xtnctx/BFRBSys/Docs/Images/300px-Nailbitebad.jpg

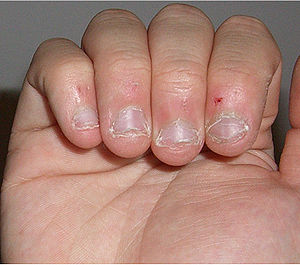
Docs/Images/300px-Nailbitebad.jpg
