xtnctx/BFRBSys/website/media/ProfilePics/anya-forger--spyxanya.png

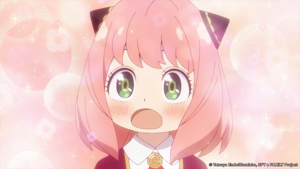
website/media/ProfilePics/anya-forger--spyxanya.png
