xtnctx/BFRBSys/Design/README.md

# Casing 3D Design
* Main
* External (Temperature & distance sensor)
