xtnctx/BFRBSys/Docs/capsule_diagram.png

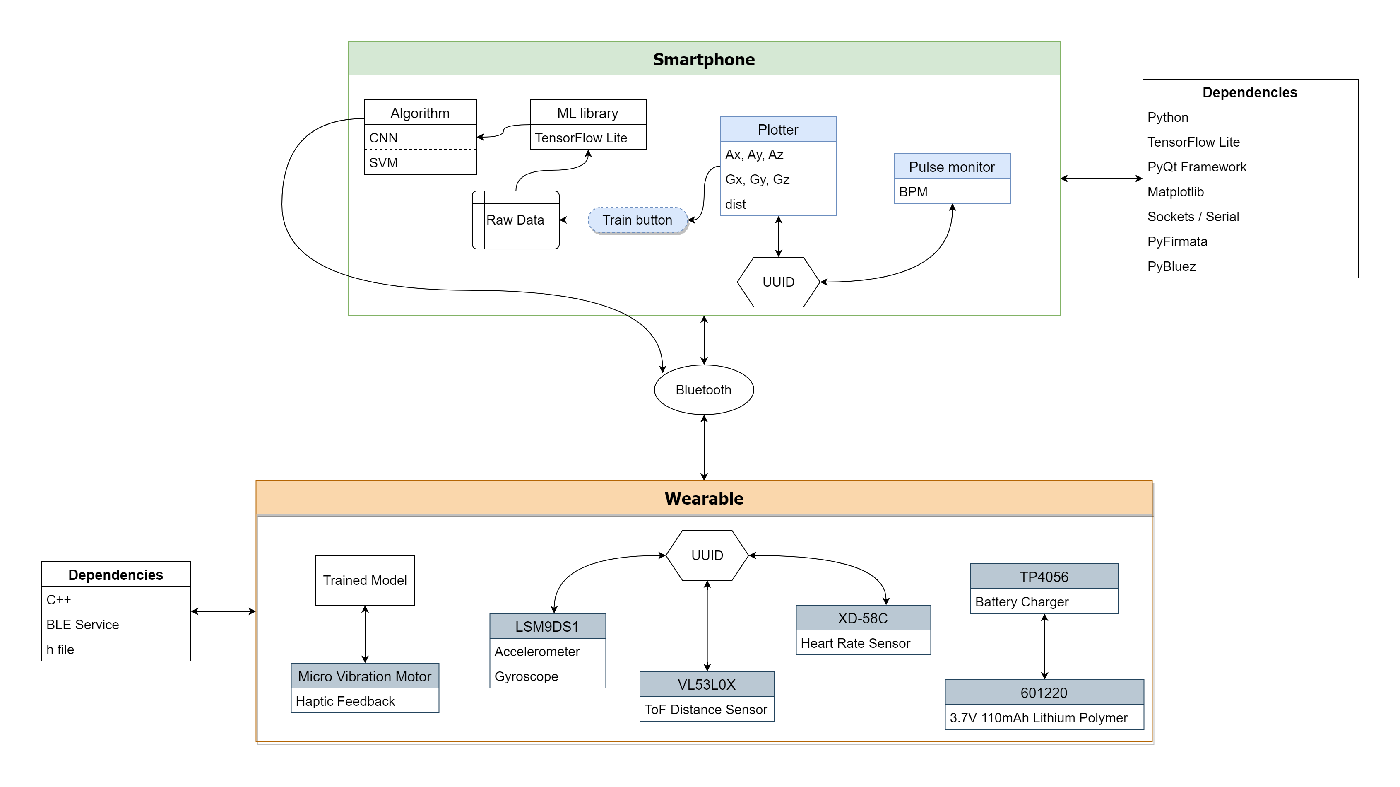
Docs/capsule_diagram.png
