xtnctx/BFRBSys/Docs/Images/10-tips-to-stop-biting-your-nails-onychophagia.jpg

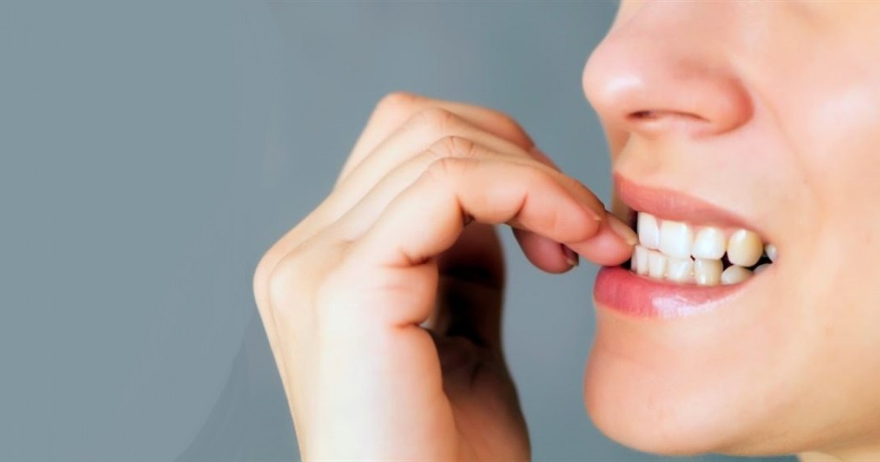
Docs/Images/10-tips-to-stop-biting-your-nails-onychophagia.jpg
