xtnctx/BFRBSys/Docs/Images/57dd166d12f08fd1103d0b2965c6aeb9.jpg

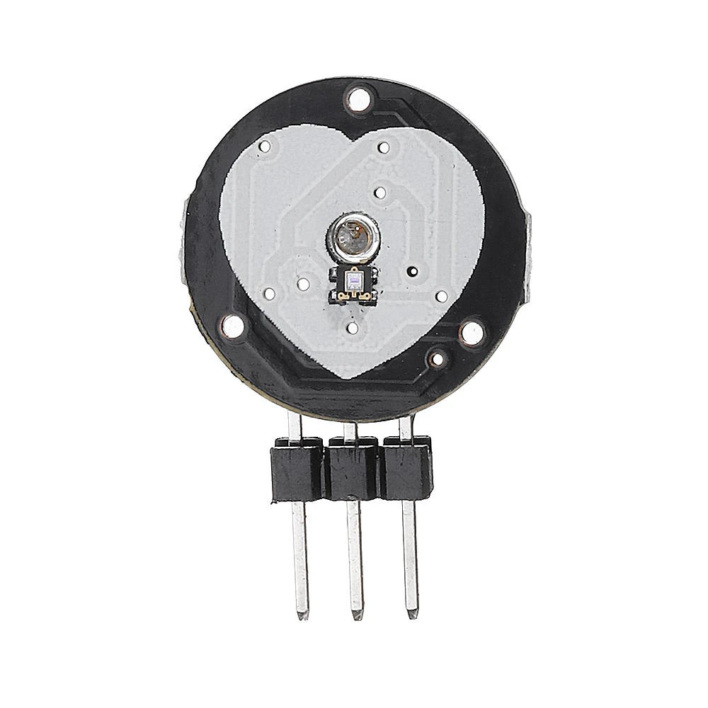
Docs/Images/57dd166d12f08fd1103d0b2965c6aeb9.jpg
