xtnctx/BFRBSys/Docs/Images/143px-Onychophagia.jpg

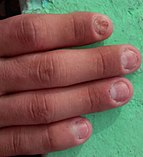
Docs/Images/143px-Onychophagia.jpg
