xtnctx/BFRBSys/Docs/Images/220px-Excoriation_disorder_affecting_face.jpg

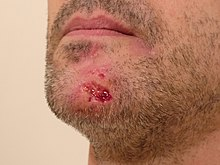
Docs/Images/220px-Excoriation_disorder_affecting_face.jpg
