xtnctx/BFRBSys/Docs/Images/300px-Trichotillomania_1.jpg

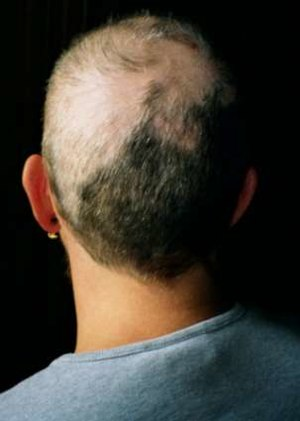
Docs/Images/300px-Trichotillomania_1.jpg
