xtnctx/BFRBSys/Docs/Images/978-3-540-29668-3_20_Part_Fig6_HTML.jpg

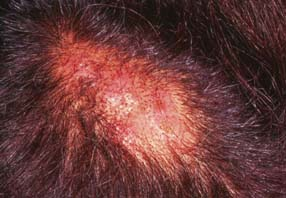
Docs/Images/978-3-540-29668-3_20_Part_Fig6_HTML.jpg
