xtnctx/BFRBSys/Docs/Images/1200px-Derma_me.jpg

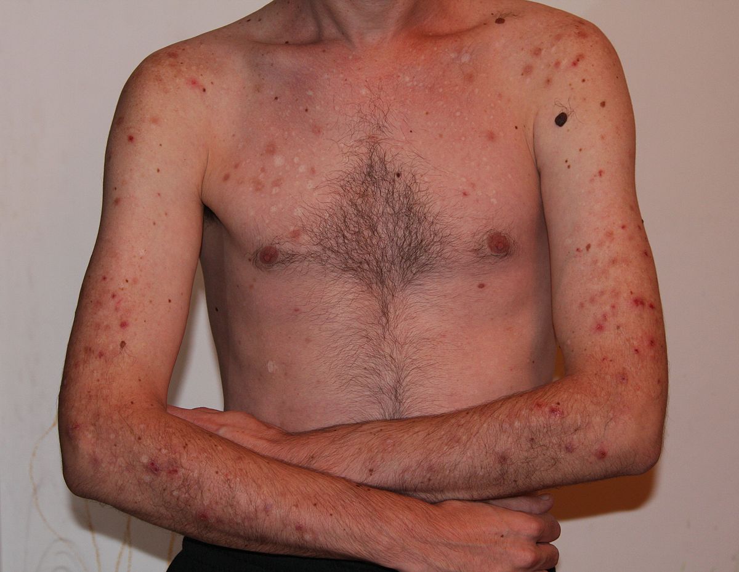
Docs/Images/1200px-Derma_me.jpg
