xtnctx/BFRBSys/Docs/Images/021239011ceeaafb5a526eff2fa90577.jpg

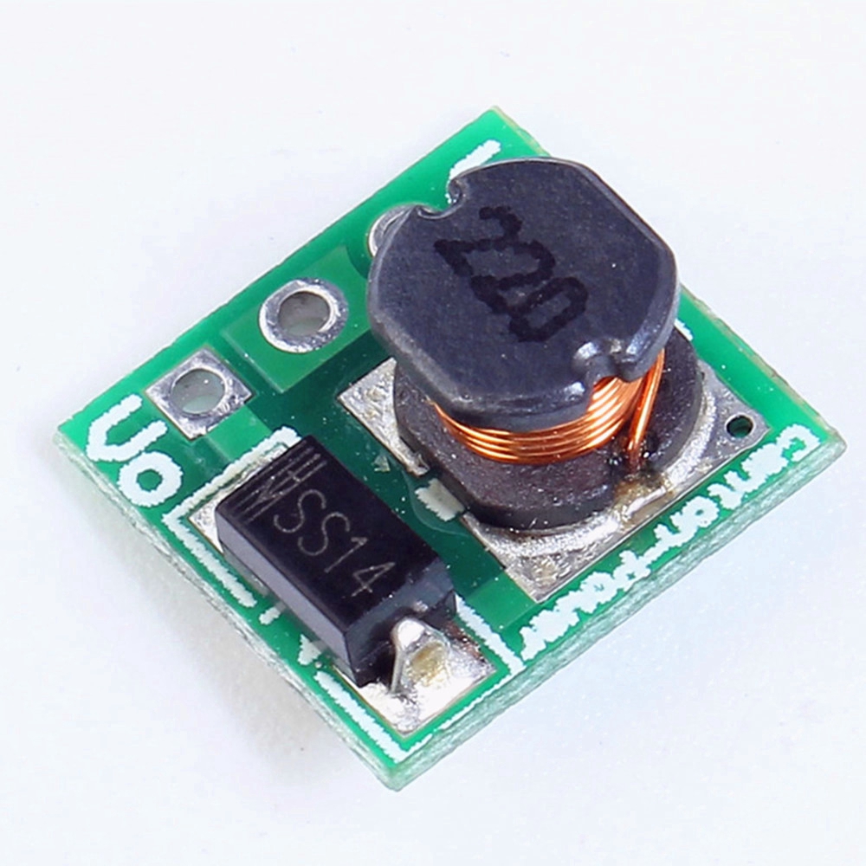
Docs/Images/021239011ceeaafb5a526eff2fa90577.jpg
