xtnctx/BFRBSys/Docs/Images/ABX00031_03.front_1000x750.jpg

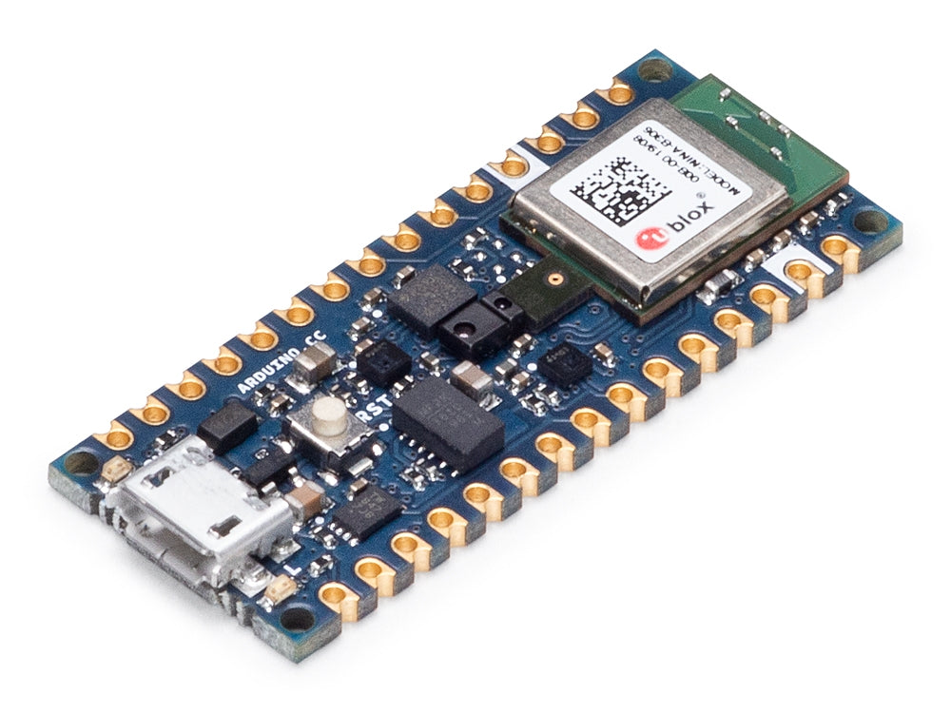
Docs/Images/ABX00031_03.front_1000x750.jpg
