xtnctx/BFRBSys/Docs/Images/capsule_diagram.png

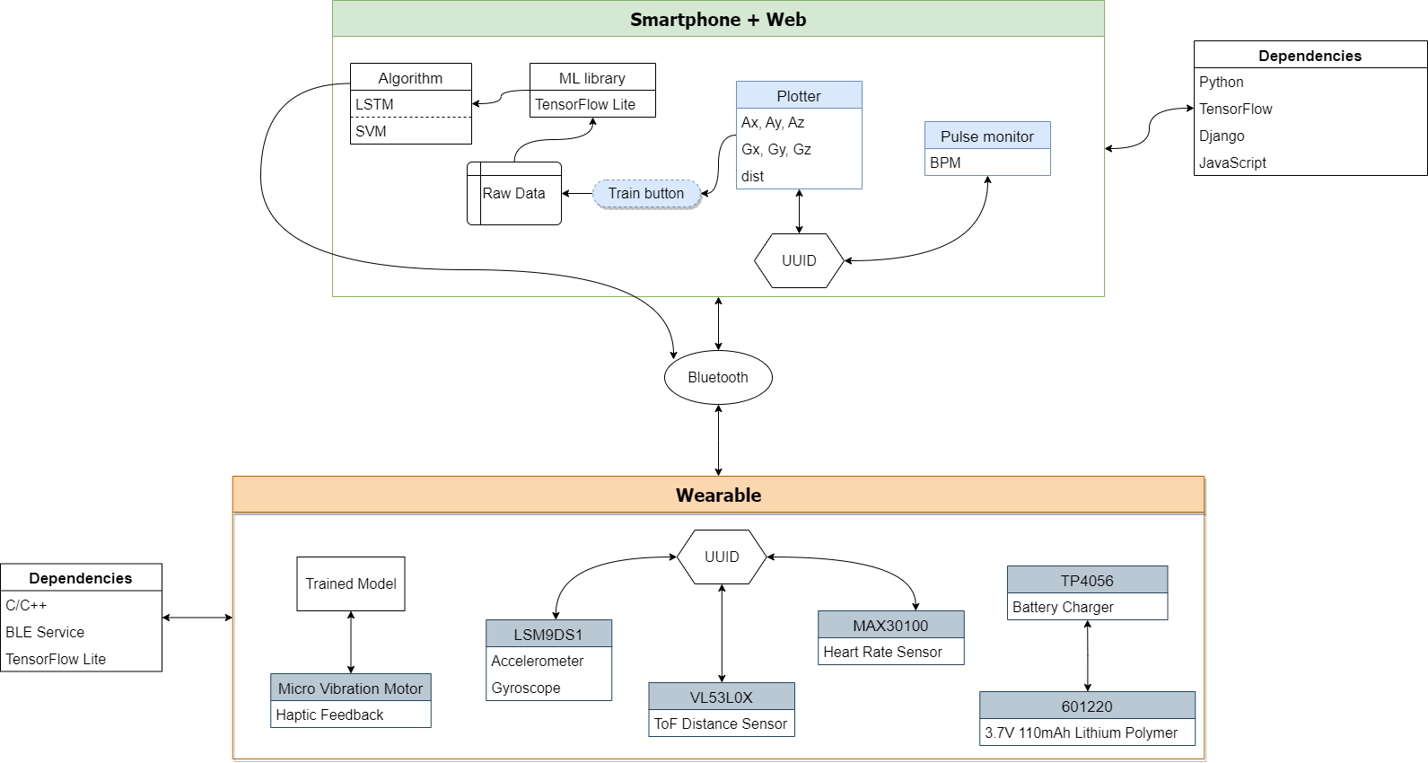
Docs/Images/capsule_diagram.png
