xtnctx/BFRBSys/Docs/Images/case3Dprint.png

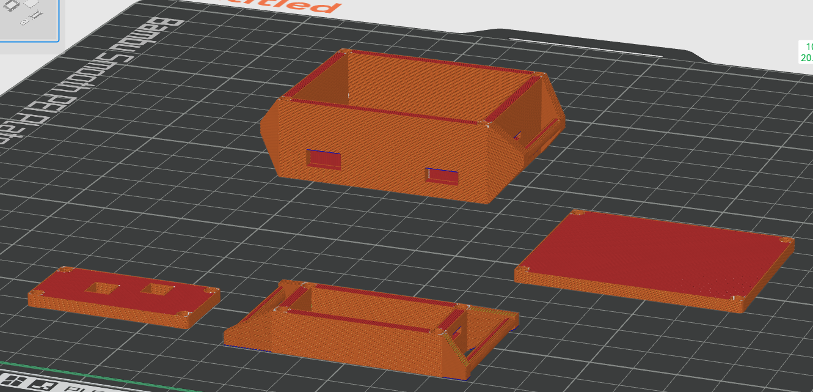
Docs/Images/case3Dprint.png
