xtnctx/BFRBSys/Docs/Images/download (1).jpg

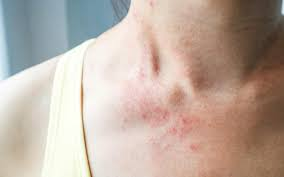
Docs/Images/download (1).jpg
