xtnctx/BFRBSys/Docs/Images/download.jpg

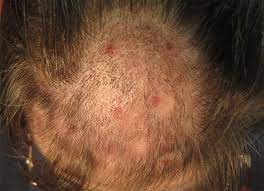
Docs/Images/download.jpg
