xtnctx/BFRBSys/Docs/Images/externalboard-development.jpg

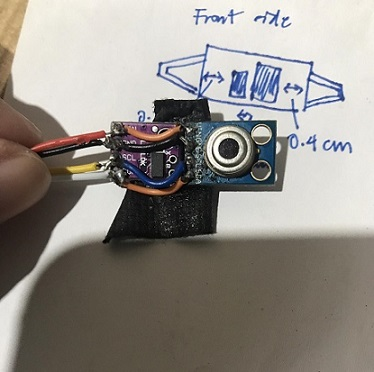
Docs/Images/externalboard-development.jpg
