xtnctx/BFRBSys/Docs/Images/FAyVRbtXoAsD0iX.png

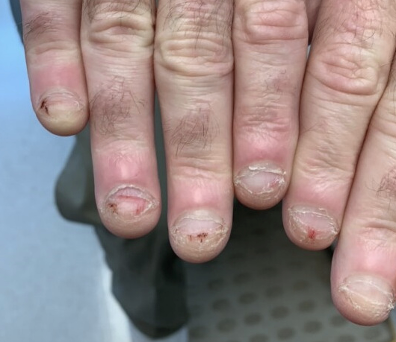
Docs/Images/FAyVRbtXoAsD0iX.png
