xtnctx/BFRBSys/Docs/Images/mainboard-development.jpg

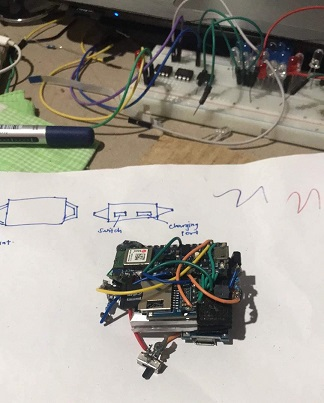
Docs/Images/mainboard-development.jpg
