xtnctx/BFRBSys/Docs/Images/nano33BS_02_acceleration.png

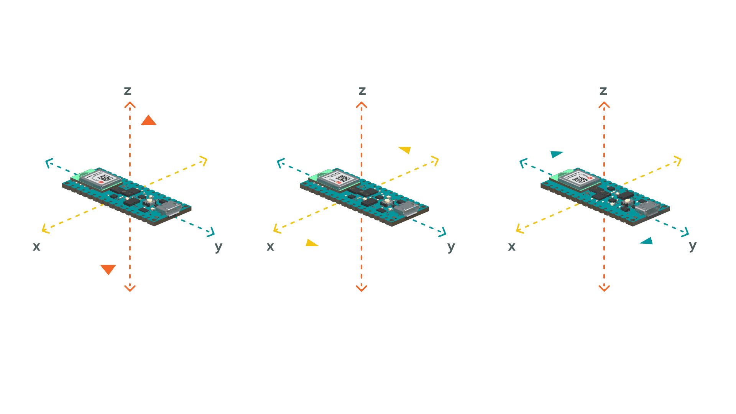
Docs/Images/nano33BS_02_acceleration.png
