xtnctx/BFRBSys/Docs/Images/nano33BS_03_IMU.png

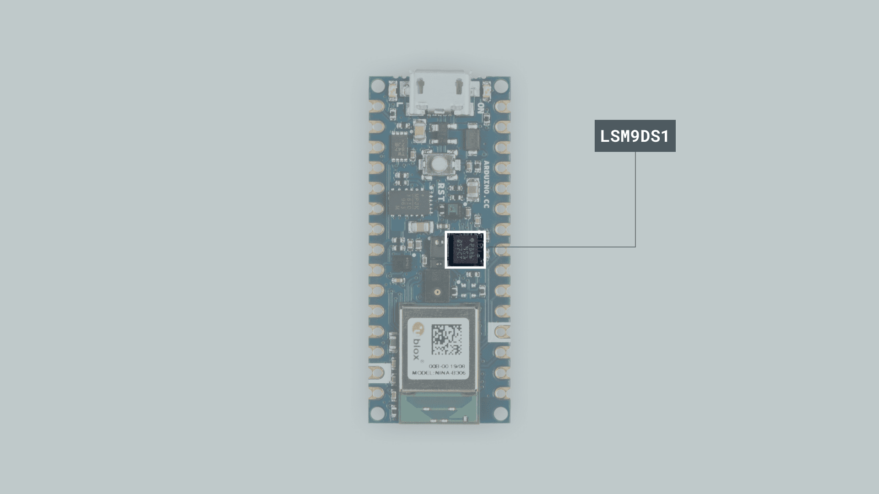
Docs/Images/nano33BS_03_IMU.png
