xtnctx/BFRBSys/Docs/Images/pickingSkin-900475670-770x553-650x428.jpg

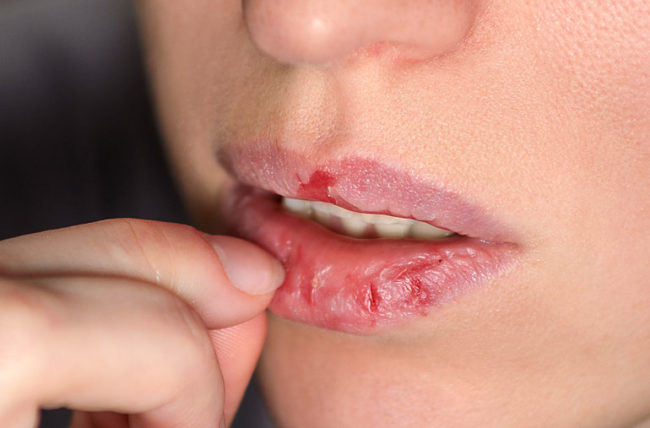
Docs/Images/pickingSkin-900475670-770x553-650x428.jpg
