xtnctx/BFRBSys/Docs/Images/render_sketch.png

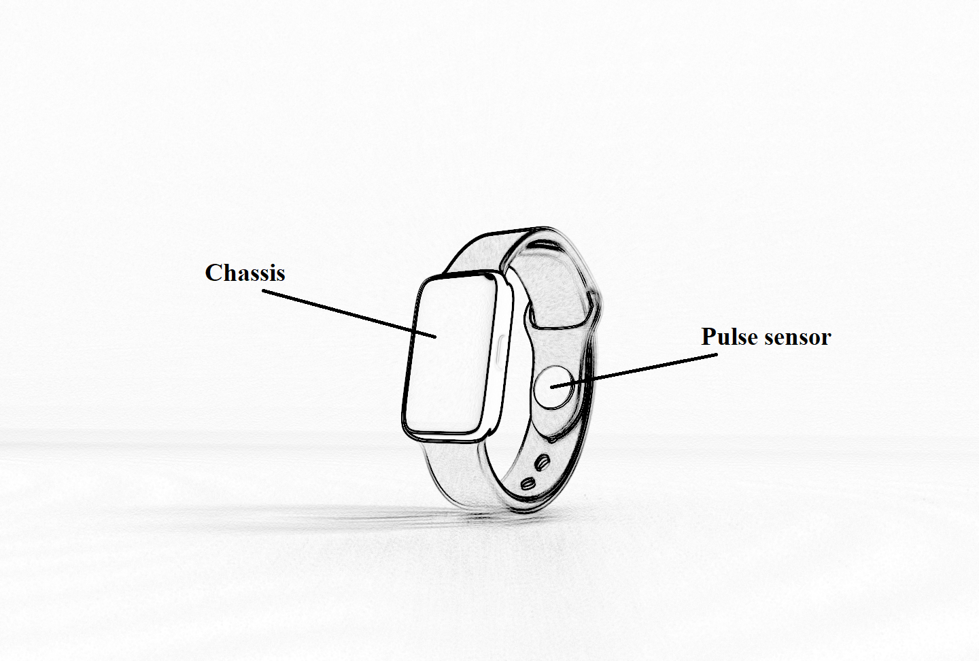
Docs/Images/render_sketch.png
