xtnctx/BFRBSys/Docs/Images/render_sketch_back.png

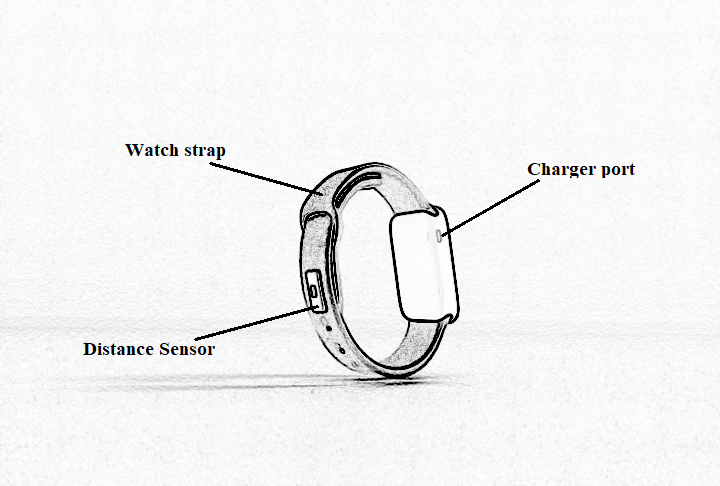
Docs/Images/render_sketch_back.png
