xtnctx/BFRBSys/Docs/Images/render_sketch_open.png

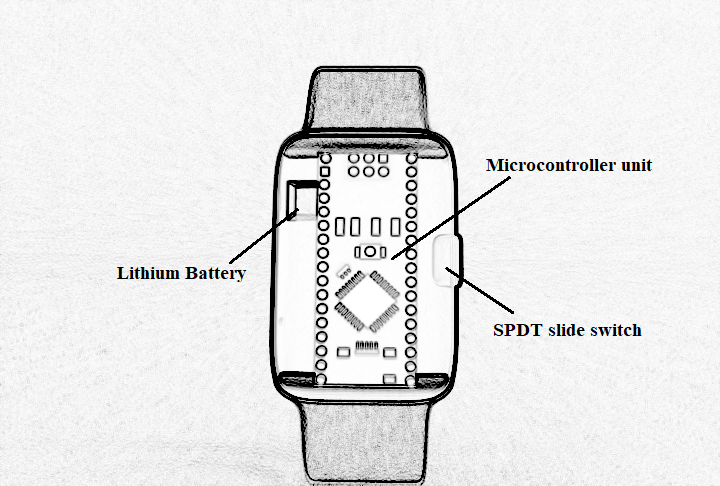
Docs/Images/render_sketch_open.png
