xtnctx/BFRBSys/Docs/Images/renders/render1.png

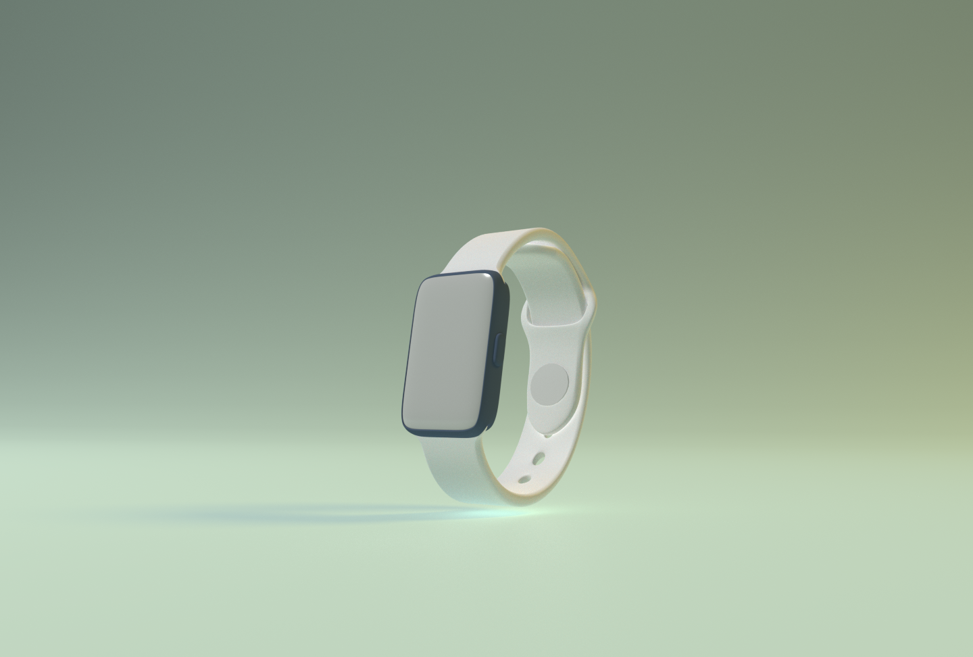
Docs/Images/renders/render1.png
