xtnctx/BFRBSys/Docs/Images/renders/render_sketch.png

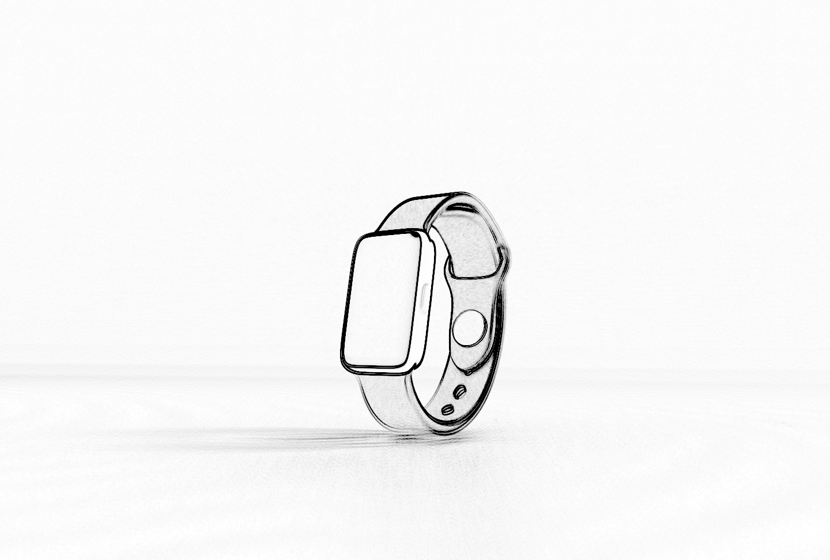
Docs/Images/renders/render_sketch.png
