xtnctx/BFRBSys/Docs/Images/renders/render_sketch_back.png

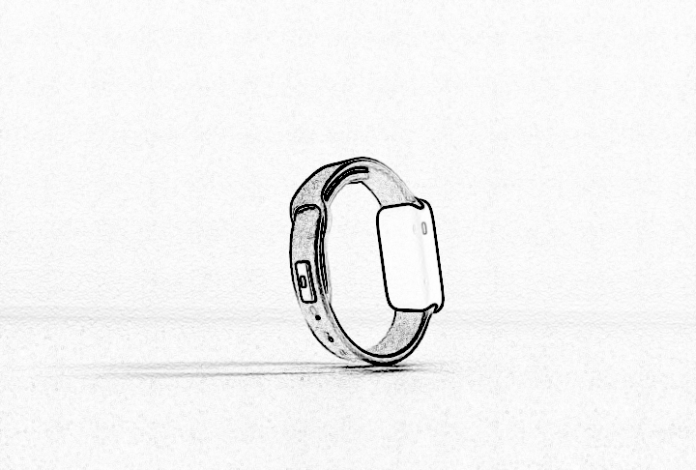
Docs/Images/renders/render_sketch_back.png
