xtnctx/BFRBSys/Docs/Images/renders/render_sketch_open.png

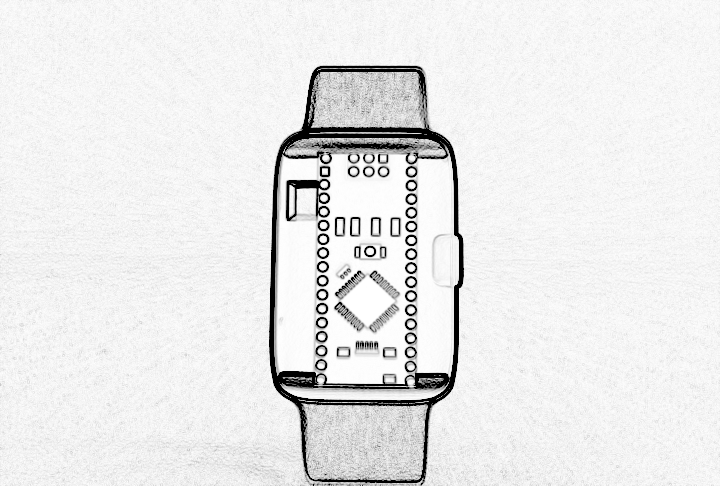
Docs/Images/renders/render_sketch_open.png
