xtnctx/BFRBSys/Docs/Images/Screenshots/monitoring_page.png

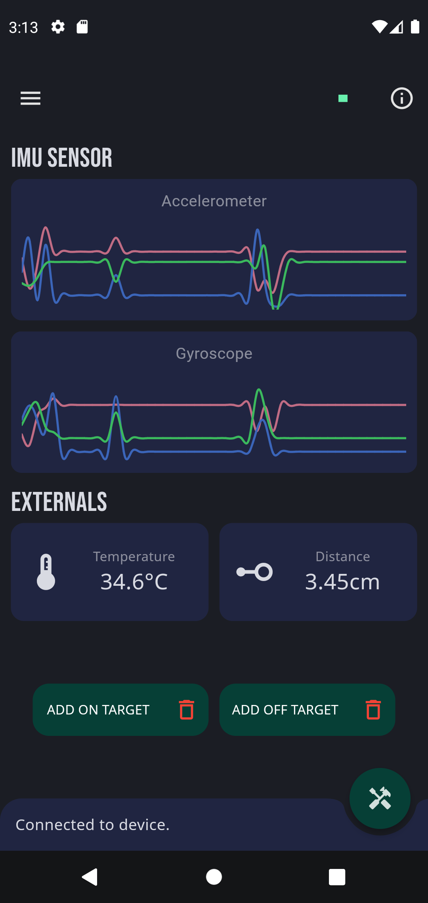
Docs/Images/Screenshots/monitoring_page.png
