xtnctx/BFRBSys/Docs/Images/signal.png

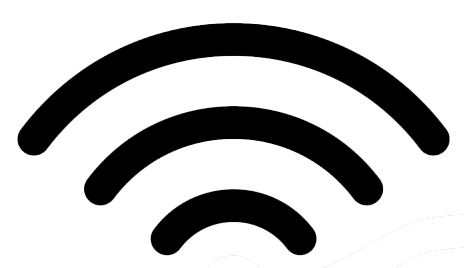
Docs/Images/signal.png
