xtnctx/BFRBSys/Docs/Images/Small-Rechargeable-601220-3-7V-100mAh-Lithium-Polymer-Battery-for-Speaker.jpg

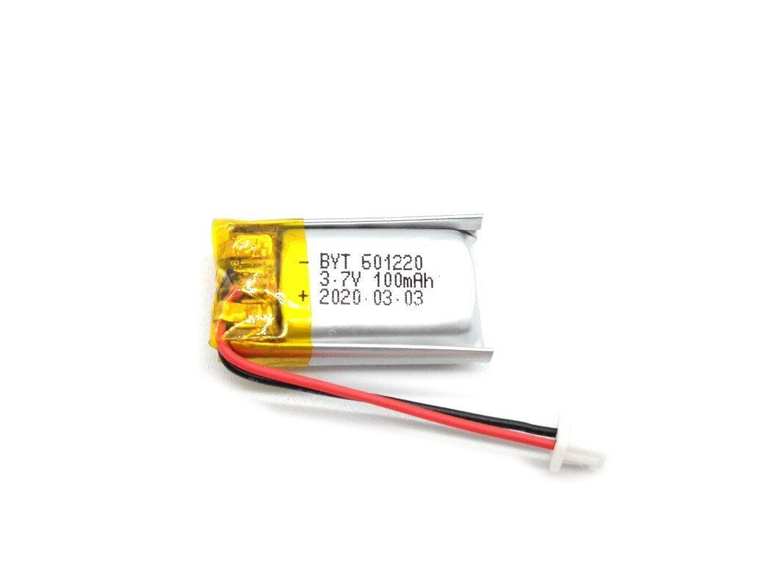
Docs/Images/Small-Rechargeable-601220-3-7V-100mAh-Lithium-Polymer-Battery-for-Speaker.jpg
