xtnctx/BFRBSys/Docs/Images/tensorflow_flowchart.png

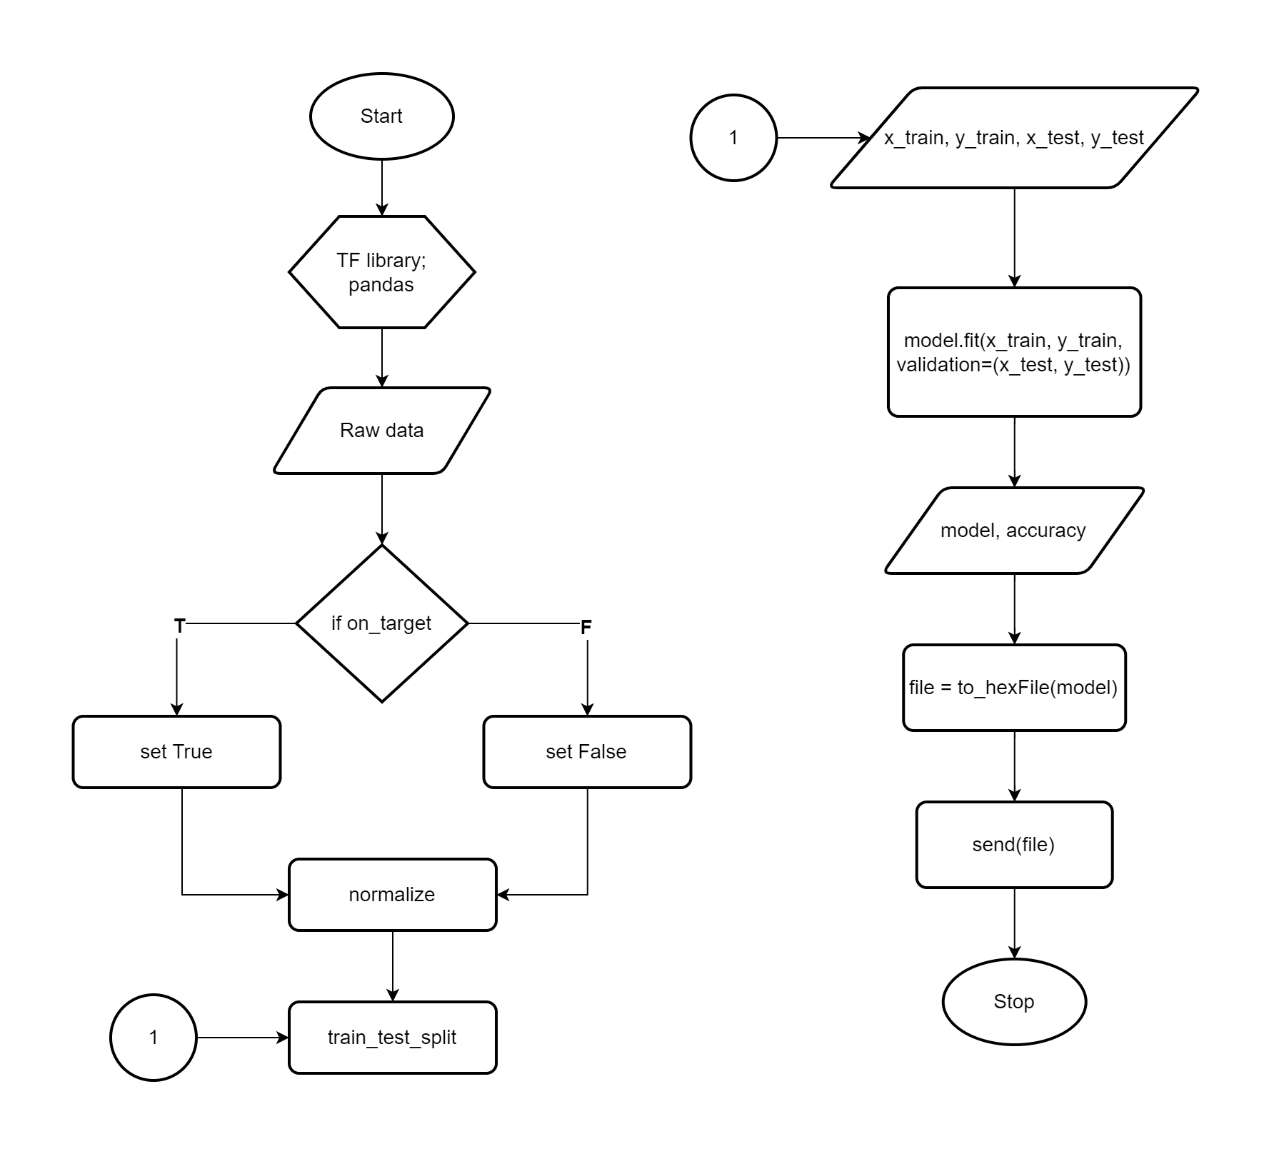
Docs/Images/tensorflow_flowchart.png
