xtnctx/BFRBSys/Docs/Images/ToF sensor.jpg

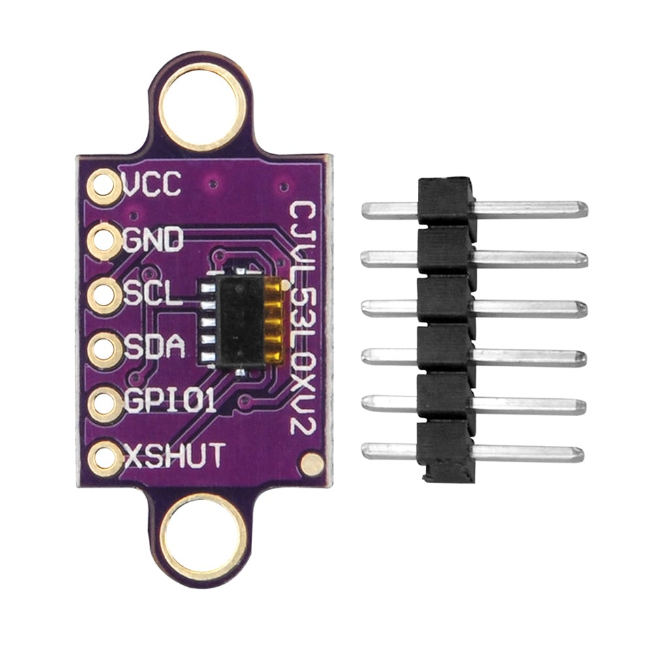
Docs/Images/ToF sensor.jpg
