xtnctx/BFRBSys/Docs/Images/tp4056.jpg

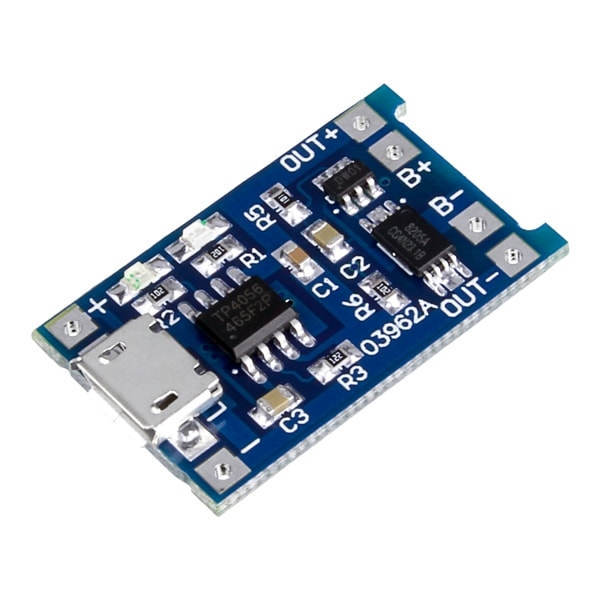
Docs/Images/tp4056.jpg
