xtnctx/BFRBSys/Docs/Images/Trichotillomania_2.jpg

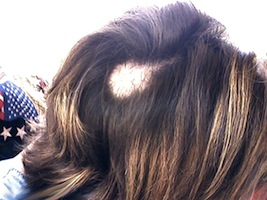
Docs/Images/Trichotillomania_2.jpg
