xtnctx/BFRBSys/FlutterApp/images/drawerbg.jpg

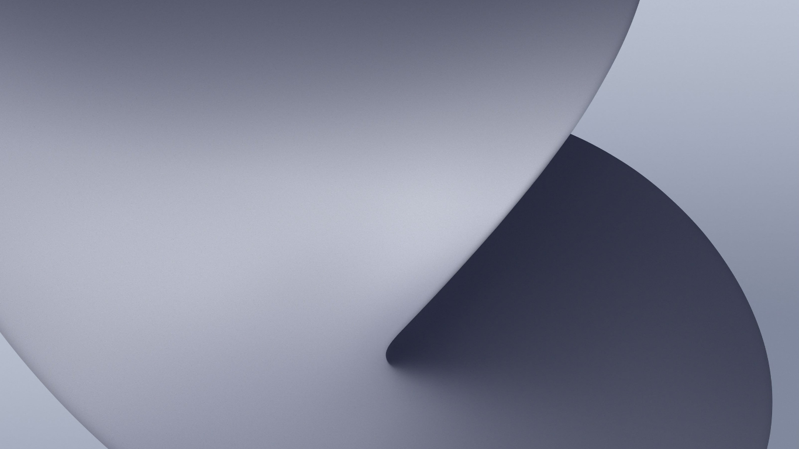
FlutterApp/images/drawerbg.jpg
