xtnctx/BFRBSys/FlutterApp/images/pixabay.jpg

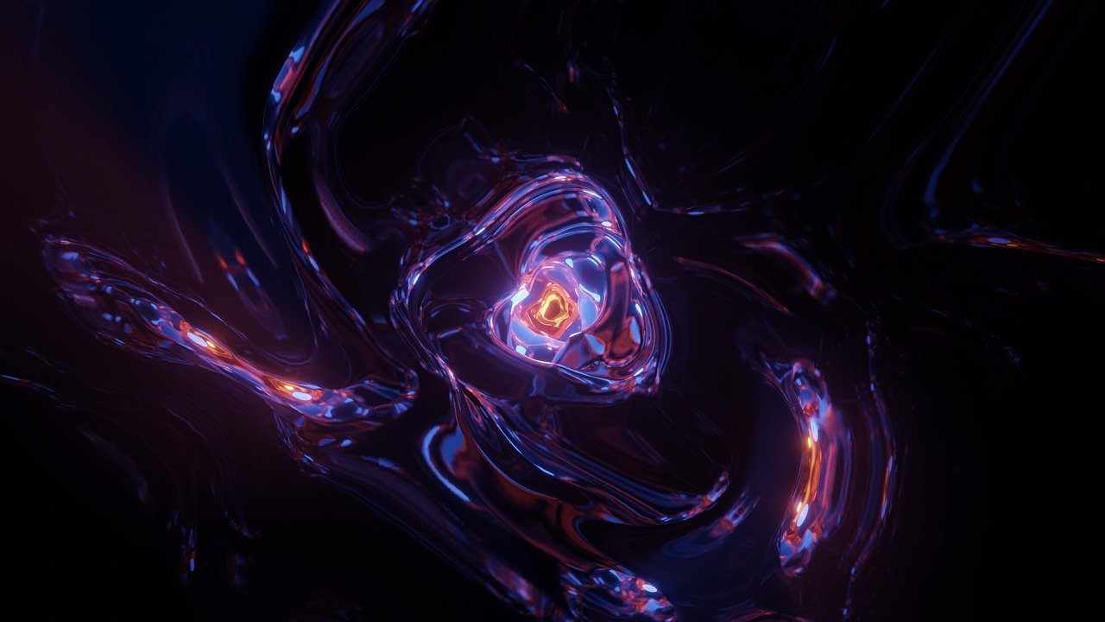
FlutterApp/images/pixabay.jpg
