xtnctx/BFRBSys/FlutterApp/images/raindrops.gif

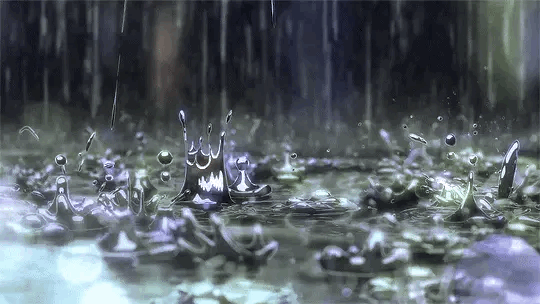
FlutterApp/images/raindrops.gif
