xtnctx/BFRBSys/website/media/default.jpg

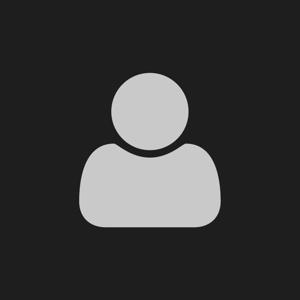
website/media/default.jpg
