xtnctx/BFRBSys/website/media/ProfilePics/christopher_bahillo_YT--ryan.jpg

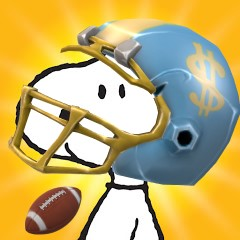
website/media/ProfilePics/christopher_bahillo_YT--ryan.jpg
