xtnctx/BFRBSys/website/media/ProfilePics/yor--yorforger321.jpg

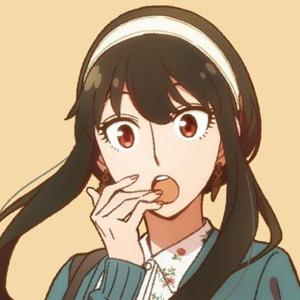
website/media/ProfilePics/yor--yorforger321.jpg
