xtnctx/BFRBSys/Docs/Images/Screenshots/result_page.png

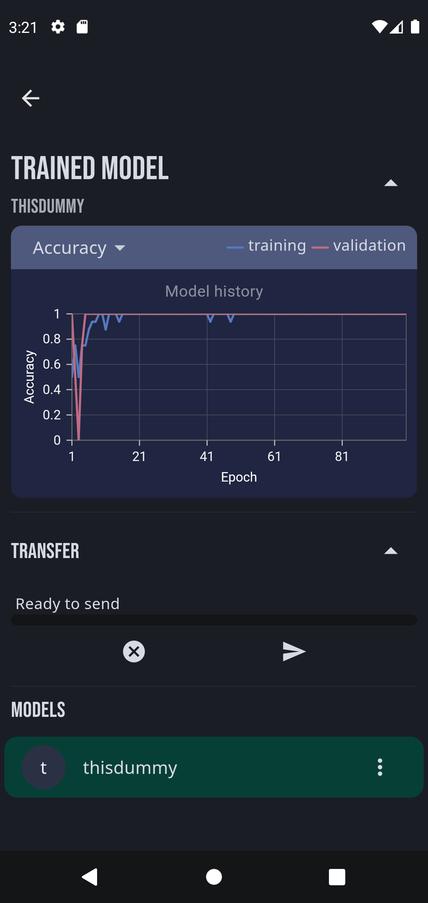
Docs/Images/Screenshots/result_page.png
