xtnctx/BFRBSys/(threads)

Thread 3 (2022-09-08):

model training in BLE Sense is not present

xtnctx, 2022-09-08:
# Fix
- after transferring the model, the device won't get trained

Closed 2023-10-20.
