xtnctx/BFRBSys/bfrbsysAPI/apis/views.py

''' Copyright 2024 Ryan Christopher Bahillo. All Rights Reserved.
Licensed under the Apache License, Version 2.0 (the "License");
you may not use this file except in compliance with the License.
You may obtain a copy of the License at
    http://www.apache.org/licenses/LICENSE-2.0
Unless required by applicable law or agreed to in writing, software
distributed under the License is distributed on an "AS IS" BASIS,
WITHOUT WARRANTIES OR CONDITIONS OF ANY KIND, either express or implied.
See the License for the specific language governing permissions and
limitations under the License.
========================================================================='''

import base64
from django.shortcuts import render
from django.http import JsonResponse
from rest_framework.response import Response
from rest_framework.decorators import api_view
from rest_framework.views import APIView
from .models import Item, TrainedModel

from .serializers import (ItemSerializer, TrainedModelSerializer, UserSerializer,
    RegisterSerializer, LoginSerializer)

from rest_framework.permissions import IsAuthenticated
from rest_framework import status, generics
from rest_framework.authentication import TokenAuthentication, SessionAuthentication, BasicAuthentication
from rest_framework.authtoken.models import Token
from .utils import *
from django.conf import settings
import os
import json

from knox.models import AuthToken
from knox.views import LoginView as KnoxLoginView

from rest_framework.permissions import AllowAny
from rest_framework.authtoken.serializers import AuthTokenSerializer
from django.contrib.auth import login
from django.forms.models import model_to_dict

from django.core.files.base import ContentFile
from .train import BFRBNeuralNetwork
import zipfile
from io import BytesIO
from django.http import HttpResponse

#
import numpy as np
import csv
import tensorflow as tf


PARAMS = ['ax', 'ay', 'az', 'gx', 'gy', 'gz', 'class']
SAMPLES_PER_HOTSPOT = 1

def home(request):
    return render(request, 'apis/home.html', {})

class NeuralNetworkBuilder(APIView):
    """
    TEST TEST TEST TEST TEST TEST TEST TEST 
    """
    
    permission_classes = (IsAuthenticated,)

    def get(self, request, format=None):
        items = Item.objects.all()
        serializer = ItemSerializer(items, many=True)
        # token, _ = Token.objects.get(user=request.user)
        

        return Response(serializer.data)
    
    def post(self, request, format=None):
        data = request.data.get('data')
        named_model = request.data.get('model_name')
        file = request.data.get("file")
        fileName = request.data.get("fileName")
        
        if named_model == '':
            named_model = 'NO_NAME_MODEL'

        # nn = BFRBNeuralNetwork(data=file).build()
        # train, val = nn.preprocessData(train_rate=0.8, val_rate=0.2)
        # history, model = nn.train(trainData=train, valData=val)
        # tflite_model = nn.to_tflite(model)

        ##################
        
        df = pd.read_csv(file)
        off_target = pd.DataFrame(df[df['class']==0].values.tolist(), columns=PARAMS)
        on_target = pd.DataFrame(df[df['class']==1].values.tolist(), columns=PARAMS)

        HOTSPOT = [off_target, on_target] # known location / class
        NUM_HOTSPOT = len(HOTSPOT)
        ONE_HOT_ENCODED_HOTSPOT = np.eye(NUM_HOTSPOT)
        N_EPOCH = 600

        inputs = []
        outputs = []

        for hotspot_index in range(NUM_HOTSPOT):

            target = HOTSPOT[hotspot_index]

            num_recordings = int(target.shape[0] / SAMPLES_PER_HOTSPOT)

            output = ONE_HOT_ENCODED_HOTSPOT[hotspot_index]

            print(f"\tThere are {num_recordings} recordings.")

            for i in range(num_recordings):
                tensor = []
                for j in range(SAMPLES_PER_HOTSPOT):
                    index = i * SAMPLES_PER_HOTSPOT + j
                    # normalize the input data, between 0 to 1:
                    # - acceleration is between: -4 to +4
                    # - gyroscope is between: -2000 to +2000
                    tensor += [
                        (float(target['ax'][index]) + 4) / 8,
                        (float(target['ay'][index]) + 4) / 8,
                        (float(target['az'][index]) + 4) / 8,
                        (float(target['gx'][index]) + 2000) / 4000,
                        (float(target['gy'][index]) + 2000) / 4000,
                        (float(target['gz'][index]) + 2000) / 4000
                    ]
                inputs.append(tensor)
                outputs.append(output)


        # convert the list to numpy array
        inputs = np.array(inputs)
        outputs = np.array(outputs)

        
        # Randomize the order of the inputs, so they can be evenly distributed for training, testing, and validation
        # https://stackoverflow.com/a/37710486/2020087
        num_inputs = len(inputs)
        randomize = np.arange(num_inputs)
        np.random.shuffle(randomize)

        # Swap the consecutive indexes (0, 1, 2, etc) with the randomized indexes
        inputs = inputs[randomize]
        outputs = outputs[randomize]

        # Split the recordings (group of samples) into three sets: training, testing and validation
        TRAIN_SPLIT = int(0.6 * num_inputs)
        TEST_SPLIT = int(0.2 * num_inputs + TRAIN_SPLIT)

        inputs_train, inputs_test, inputs_validate = np.split(inputs, [TRAIN_SPLIT, TEST_SPLIT])
        outputs_train, outputs_test, outputs_validate = np.split(outputs, [TRAIN_SPLIT, TEST_SPLIT])
        
        # build the model and train it
        model = tf.keras.Sequential()
        model.add(tf.keras.layers.Dense(50, activation='relu')) # relu is used for performance
        model.add(tf.keras.layers.Dense(15, activation='relu'))
        model.add(tf.keras.layers.Dense(NUM_HOTSPOT, activation='softmax')) # softmax is used, because we only expect one hotspot to occur per input
        model.compile(optimizer='rmsprop', loss='mse', metrics=['mae'])
        # history = model.fit(inputs_train, outputs_train, epochs=N_EPOCH, batch_size=1,
        #                     validation_data=(inputs_validate, outputs_validate),
        #                     callbacks=[EpochPrintingCallback(msg, N_EPOCH)])

        history = model.fit(inputs_train, outputs_train, epochs=N_EPOCH, batch_size=1,
                            validation_data=(inputs_validate, outputs_validate))

        
        # Convert the model to the TensorFlow Lite format without quantization
        converter = tf.lite.TFLiteConverter.from_keras_model(model)
        converter.optimizations = [tf.lite.Optimize.OPTIMIZE_FOR_SIZE]
        tflite_model = converter.convert()

        ############

        owner_file = str(named_model).replace(" ", "_") + f'--{request.user.username}'
        data = {
            'owner': request.user.id,
            'model_name': named_model,
            'file': ContentFile(bytes(model_to_databytes(tflite_model), 'utf-8'), 
                                name=owner_file + '_model.h'
                                ),
            'callback_file': ContentFile(bytes(callback_string(history), 'utf-8'), 
                                name=owner_file + '_callback.csv'),
        }

        serializer = TrainedModelSerializer(data=data)
        if serializer.is_valid():
            serializer.save()
            return Response(serializer.data, status=status.HTTP_201_CREATED)
        return Response(serializer.errors, status=status.HTTP_400_BAD_REQUEST)



    # def post(self, request, format=None):
    #     data = request.data.get('data')
    #     named_model = request.data.get('model_name')
    #     file = request.data.get("file") # Must be csv encoded
    #     fileName = request.data.get("fileName") # Must be csv file format

    #     dataset = ContentFile(base64.b64decode(file), fileName)
    #     df = pd.read_csv(dataset)
    #     print(df)

    #     if named_model == '':
    #         named_model = 'NO_NAME'
    #     # Save as temporary
    #     USER_TEMP_FILE = os.path.join(settings.MEDIA_ROOT, request.user.username + '_TEMPFILE.h')
    #     with open(USER_TEMP_FILE, 'w') as temp:
    #         # temp.write(hex_to_c_array(tflite_model))
    #         temp.write('hello')

    #     # Then save to database
    #     f = open(USER_TEMP_FILE, 'rb')
    #     data = {
    #         'owner': request.user.id,
    #         'model_name': named_model,
    #         'file': File(f, name=str(named_model).replace(" ", "_") + f'--{request.user.username}' + '.h')
    #     }
            
    #     model_string = rmv_file_spaces(USER_TEMP_FILE)
    #     print(model_string)

    #     serializer = TrainedModelSerializer(data=data)
    #     if serializer.is_valid():
    #         serializer.save()
    #         f.close()
    #         remove_file(USER_TEMP_FILE) # end of using temp model
    #         return Response(serializer.data, status=status.HTTP_201_CREATED)

    #     f.close()
    #     remove_file(USER_TEMP_FILE)
    #     return Response(serializer.errors, status=status.HTTP_400_BAD_REQUEST)


# class UserCreation(APIView):
#     """
#     API View to create or get a list of all the registered
#     users. GET request returns the registered users whereas
#     a POST request allows to create a new user.
#     """
#     permission_classes = [AllowAny]
    

#     # Delete later
#     def get(self, format=None):
#         users = User.objects.all()
#         serializer = UserSerializer(users, many=True)
#         return Response(serializer.data)

#     def post(self, request):
#         serializer = UserSerializer(data=request.data)
#         if serializer.is_valid(raise_exception=ValueError):
#             serializer.create(validated_data=request.data)
#             return Response(
#                 serializer.data,
#                 status=status.HTTP_201_CREATED
#             )
#         return Response(
#             {
#                 "error": True,
#                 "error_msg": serializer.error_messages,
#             },
#             status=status.HTTP_400_BAD_REQUEST
#         )


def get_all_user_models(request):
    # Files (local path) to put in the .zip
    # FIXME: Change this (get paths from DB etc)
    userTrainedModels = TrainedModel.objects.filter(owner=request.user)

    # Folder name in ZIP archive which contains the above files
    # E.g [thearchive.zip]/somefiles/file2.txt
    # FIXME: Set this to something better
    zip_subdir = request.user.username
    zip_filename = "%s.zip" % zip_subdir

    # Open StringIO to grab in-memory ZIP contents
    s = BytesIO()

    # The zip compressor
    zf = zipfile.ZipFile(s, "w")

    for model in userTrainedModels:
        # for fpath in filenames:
        # Calculate path for file in zip
        fpath = f'./media/{model.file.name}'
        fdir, fname = os.path.split(fpath)
        # TrainedModels
        zip_path = os.path.join(zip_subdir, f'{model.model_name}/{fname}')
        zf.write(fpath, zip_path)

        # Callbacks
        fpath = f'./media/{model.callback_file.name}'
        fdir, fname = os.path.split(fpath)
        zip_path = os.path.join(zip_subdir, f'{model.model_name}/{fname}')
        zf.write(fpath, zip_path)

        # Info
        data = model_to_dict(model)
        data['file'] = str(data['file'])
        data['callback_file'] = str(data['callback_file'])
        json_data = json.dumps(data, indent=4)
        zip_path = os.path.join(zip_subdir, f'{model.model_name}/{model.model_name}_info.json')
        zf.writestr(zip_path, json_data)
        s.seek(0)

    # Must close zip for all contents to be written
    zf.close()

    # Grab ZIP file from in-memory, make response with correct MIME-type
    resp = HttpResponse(s.getvalue(), content_type="application/x-zip-compressed")
    # ..and correct content-disposition
    resp['Content-Disposition'] = 'attachment; filename=%s' % zip_filename
    return resp


class RegisterAPI(generics.GenericAPIView):
    serializer_class = RegisterSerializer

    def post(self, request, *args, **kwargs):
        serializer = self.get_serializer(data=request.data)
        serializer.is_valid(raise_exception=True)
        user = serializer.save()
        _, token = AuthToken.objects.create(user)
        return Response({
            "user": UserSerializer(user, context=self.get_serializer_context()).data,
            "token": token
        })



class LoginAPI(generics.GenericAPIView):
    serializer_class = LoginSerializer
    permission_classes = ()

    def post(self, request, *args, **kwargs):
        serializer = self.get_serializer(data=request.data)
        serializer.is_valid(raise_exception=True)
        user = serializer.validated_data
        _, token = AuthToken.objects.create(user)
        return Response({
            "user": UserSerializer(user, context=self.get_serializer_context()).data,
            "token": token
        })


class UserAPI(generics.RetrieveAPIView):
  permission_classes = [IsAuthenticated]
  serializer_class = UserSerializer

  def get_object(self):
    return self.request.user
