xtnctx/BFRBSys/bfrbsysAPI/apis/serializers.py

''' Copyright 2024 Ryan Christopher Bahillo. All Rights Reserved.
Licensed under the Apache License, Version 2.0 (the "License");
you may not use this file except in compliance with the License.
You may obtain a copy of the License at
    http://www.apache.org/licenses/LICENSE-2.0
Unless required by applicable law or agreed to in writing, software
distributed under the License is distributed on an "AS IS" BASIS,
WITHOUT WARRANTIES OR CONDITIONS OF ANY KIND, either express or implied.
See the License for the specific language governing permissions and
limitations under the License.
========================================================================='''

from rest_framework import serializers
from .models import Item, TrainedModel
from django.contrib.auth.models import User
from rest_framework.validators import UniqueTogetherValidator
from django.contrib.auth import authenticate

class ItemSerializer(serializers.ModelSerializer):
    class Meta:
        model = Item
        fields = '__all__'

class TrainedModelSerializer(serializers.ModelSerializer):
    class Meta:
        model = TrainedModel
        fields = '__all__'



# class UserSerializer(serializers.ModelSerializer):
#     def create(self, validated_data):
#         user = User.objects.create_user(**validated_data)
#         return user

#     class Meta:
#         model = User
#         fields = (
#             'username',
#             'first_name',
#             'last_name',
#             'email',
#             'password',
#         )
#         validators = [
#             UniqueTogetherValidator(
#                 queryset=User.objects.all(),
#                 fields=['username', 'password']
#             )
#         ]

class UserSerializer(serializers.ModelSerializer):
    class Meta:
        model = User
        fields = ('id', 'username', 'email',)

class RegisterSerializer(serializers.ModelSerializer):
    class Meta:
        model = User
        fields = ('id', 'username', 'email', 'password',)
        extra_kwargs = {'password': {'write_only': True}}
    
    def create(self, validated_data):
        user = User.objects.create_user(**validated_data)
        return user

class LoginSerializer(serializers.Serializer):
    username = serializers.CharField()
    password = serializers.CharField()

    def validate(self, data):
        user = authenticate(**data)
        if user and user.is_active:
            return user
        raise serializers.ValidationError("Incorrect Credentials")
