xtnctx/BFRBSys/bfrbsysAPI/apis/models.py

from django.db import models
from django.contrib.auth.models import User

# Create your models here.
class Item(models.Model):
    name = models.CharField(max_length=200)
    created = models.DateTimeField(auto_now_add=True)

class TrainedModel(models.Model):
    owner = models.ForeignKey(User, default=None, on_delete=models.CASCADE)
    model_name = models.CharField(max_length=150)
    created_at = models.DateTimeField(auto_now_add=True)
    updated_at = models.DateTimeField(auto_now=True)
    file = models.FileField(
                            upload_to='TrainedModels', 
                            default='settings.MEDIA_ROOT/default.txt'
                            )
    callback_file = models.FileField(
                            upload_to='Callbacks', 
                            default='settings.MEDIA_ROOT/default.txt'
                            )
    def __str__(self) -> str:
        return f'{self.owner.username}'
