xtnctx/BFRBSys/(commit log)

2022-07-22 accelerometer & gyro readings
2022-07-25 proximity & temperature readings
2022-07-26 model input
    [myfile.csv]
2022-08-17 get training status & UX fixed
    [admin.py, models.py]
2022-08-21 Load Tensorflow Lite model from SD card in Arduino
2022-08-23 Update and rename sample.md to NOTICE.md
2022-08-31 Bug fixed - deletion of default.jpg
    [views.py]
2022-09-04 fix admin and accounts
    [admin.py]
2022-09-04 fix admin and app ( β )
    [admin.py, models.py, views.py]
2022-11-23 add function in target buttons
2023-10-10 Button: design adjustment
2023-10-31 Add build button
2023-11-01 Remove floating action button #13
2024-02-04 adds currentUser & currentDate after request
